TO-08/kicad-senkouka-lib/README.md

## kicad-senkouka-lib
本ライブラリは、授業で使用するKicadのライブラリになります。

## ライセンス
ライセンスはフリーとしますが、再配布は行わないようにしてください。<br>
また、個人的に使用しても良いですが、何があっても自己責任でお願いします。

## インストール方法
①GitHubにあるコードを任意の場所にダウンロードします。<br>
②ダウンロードしたフォルダにある『シンボルライブラリ』と『フットプリントライブラリ』をKicadのライブラリに登録します。<br>
③Kicadのライブラリへの登録は、『設定』の各ライブラリの管理から行います。<br>
<br>
④ライブラリの管理画面を開いたら、下の方にある『フォルダを開く』を選択して、ダウンロードしたライブラリを選択します。<br>
<br>
<br>
⑤『senkouka_lib』がライブラリに登録されていればOKです。<br>
　※『フットプリントライブラリ』も同様に登録してください。<br>
<br>
