TO-08/kicad-senkouka-lib/3D/1N5226B.stp

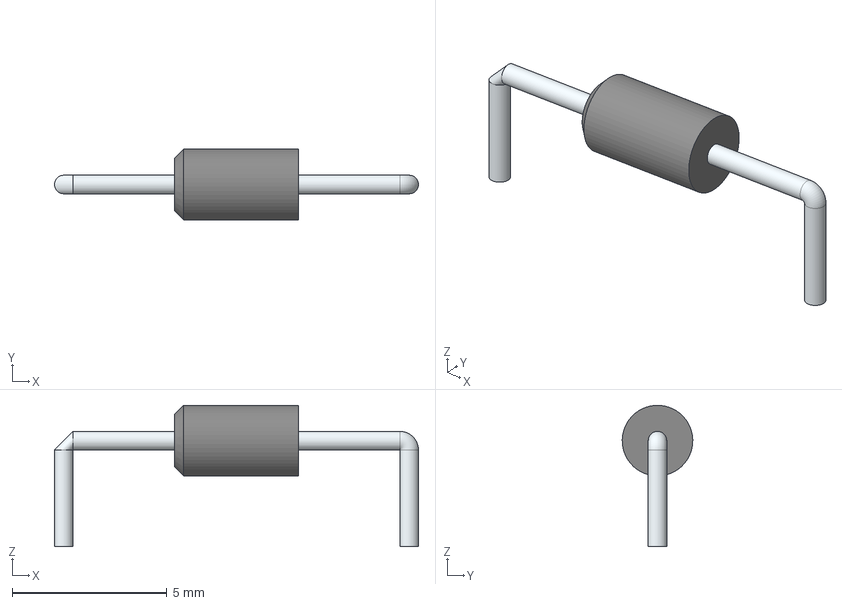
[picture p1: CAD file, 2023-06-08]
3D/1N5226B.stp
11.7 x 2.28 x 4.56 mm
