TO-08/kicad-senkouka-lib/3D/LM2940CT-12_NOPB.stp

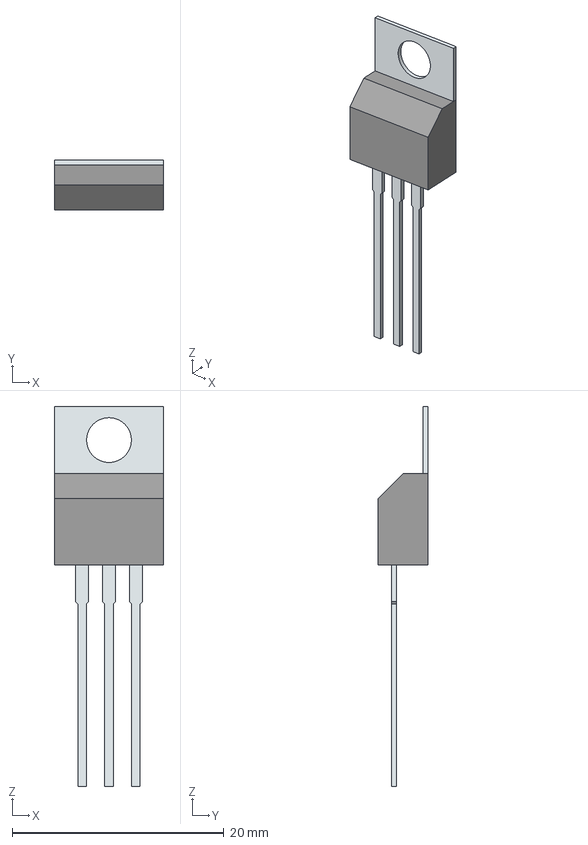
[picture p2: CAD file, 2023-06-08]
3D/LM2940CT-12_NOPB.stp
10.3 x 4.70 x 35.9 mm
Tab
PinsArray
