TO-08/kicad-senkouka-lib/3D/B5B-XH-A__LF__SN_.stp

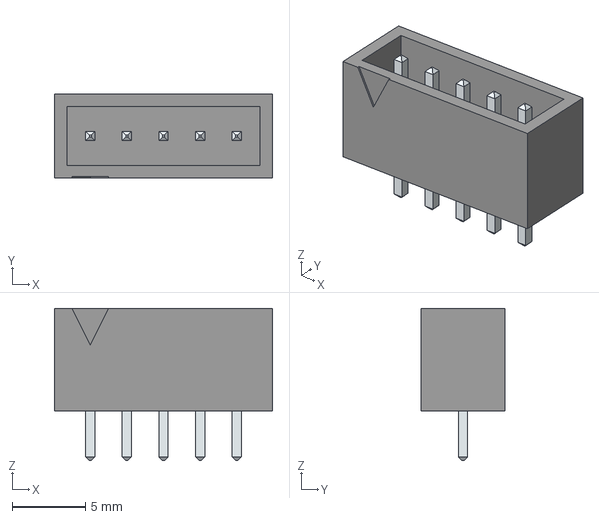
[picture p3: CAD file, 2023-06-08]
3D/B5B-XH-A__LF__SN_.stp
14.9 x 5.75 x 10.4 mm
LeadsArray
