TO-08/kicad-senkouka-lib/3D/SS2040FL.stp

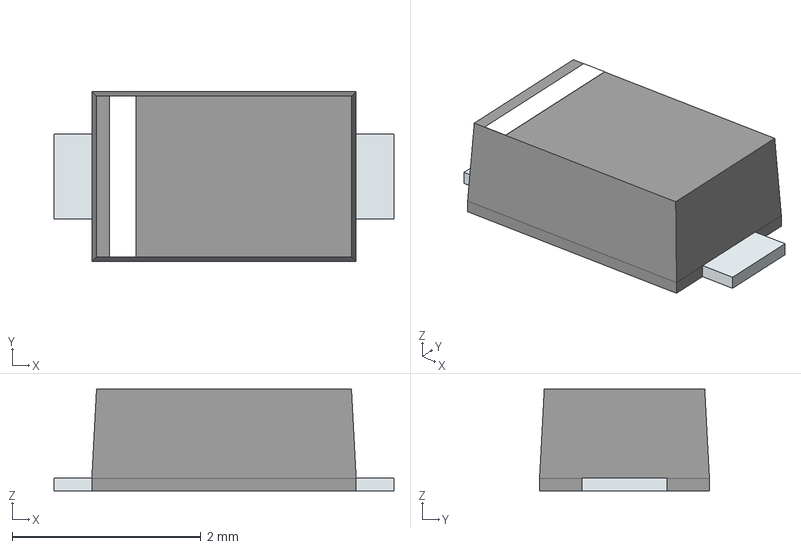
[picture p5: CAD file, 2023-06-08]
3D/SS2040FL.stp
3.60 x 1.80 x 1.08 mm
PinKIdent
PinK
PinA
