TO-08/kicad-senkouka-lib/3D/B2B-XH-A_LF__SN_.stp

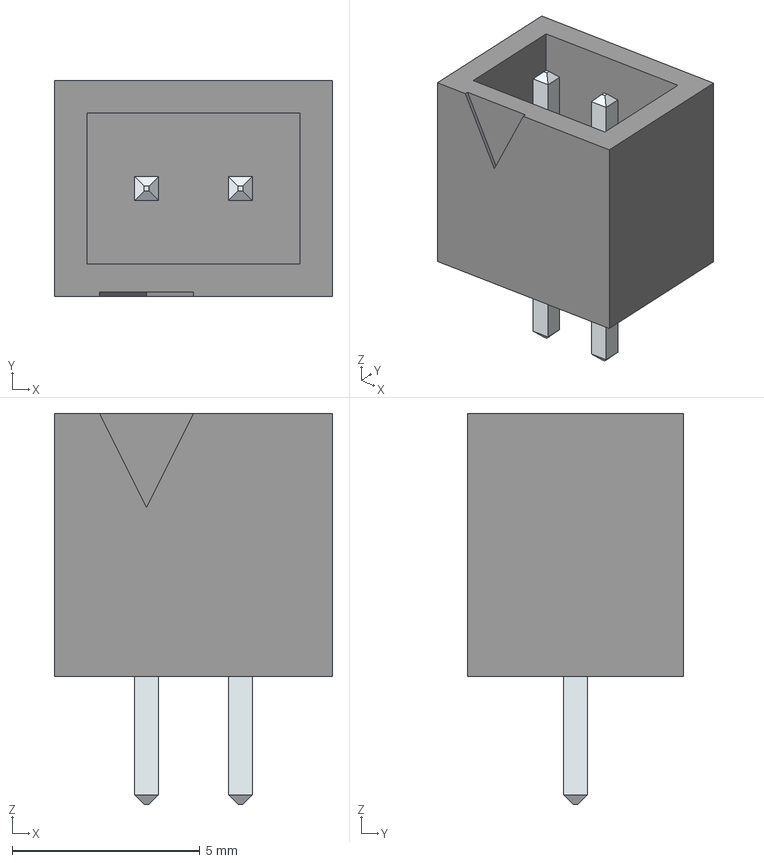
[picture p7: CAD file, 2023-06-08]
3D/B2B-XH-A_LF__SN_.stp
7.40 x 5.75 x 10.4 mm
LeadsArray
