TO-08/kicad-senkouka-lib/3D/B6B-XH-A_LF__SN_.stp

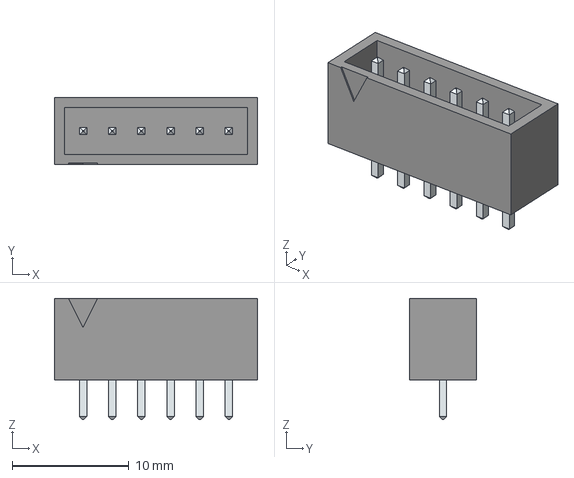
[picture p8: CAD file, 2023-06-08]
3D/B6B-XH-A_LF__SN_.stp
17.4 x 5.75 x 10.4 mm
LeadsArray
