TO-08/kicad-senkouka-lib/3D/TC33X-2-102E.stp

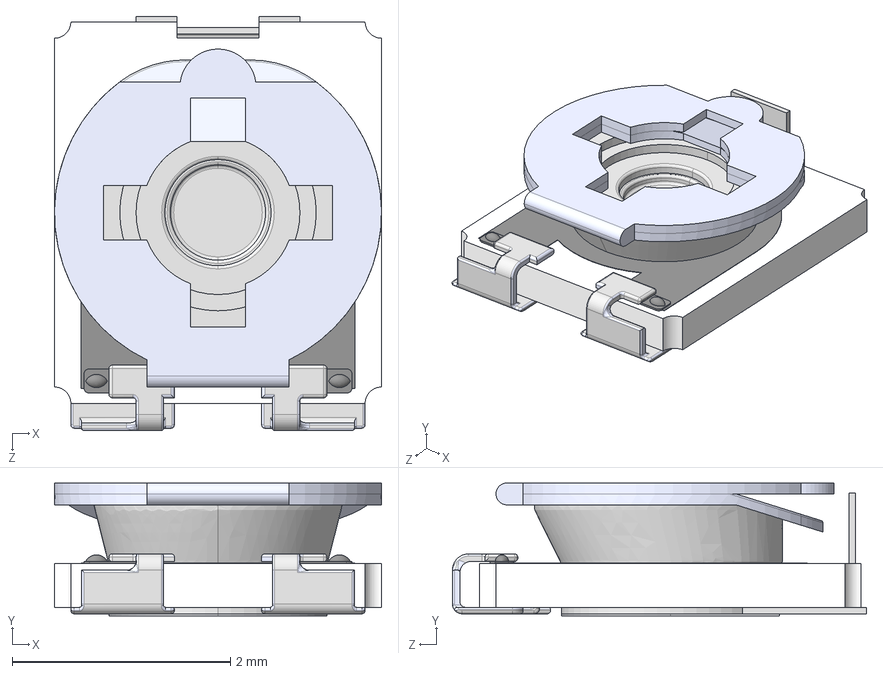
[picture p9: CAD file, 2023-06-08]
3D/TC33X-2-102E.stp
3.00 x 1.22 x 3.80 mm
