TO-08/kicad-senkouka-lib/3D/AE_TPS63802_v7_cp.step

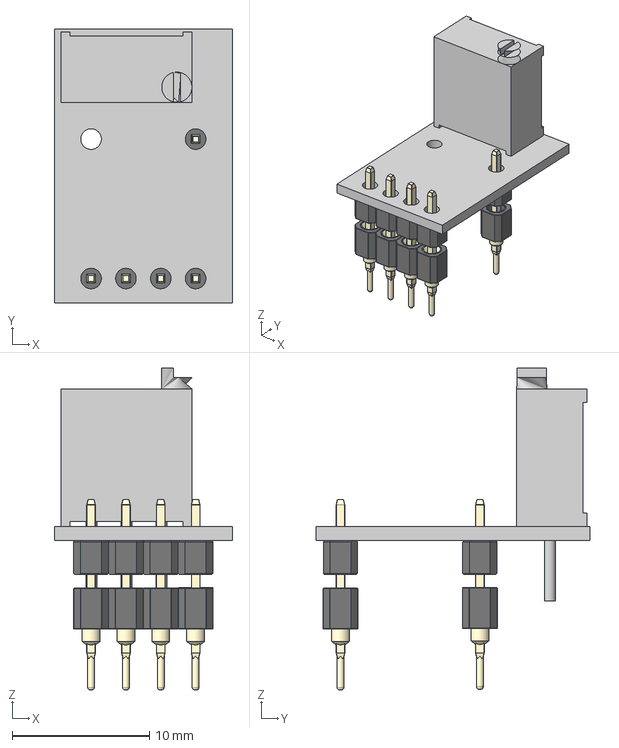
[picture p10: CAD file, 2023-06-08]
3D/AE_TPS63802_v7_cp.step
13.0 x 20.0 x 23.5 mm
