TO-08/kicad-senkouka-lib/3D/IR2302PBF.stp

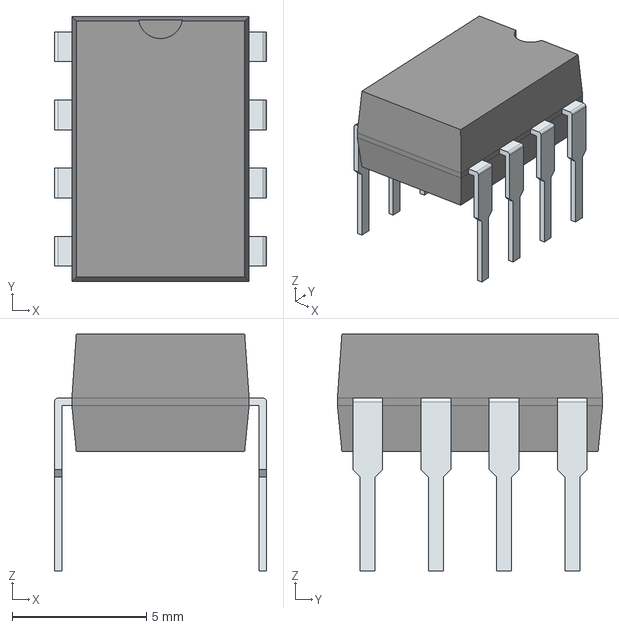
[picture p11: CAD file, 2023-06-08]
3D/IR2302PBF.stp
7.90 x 9.88 x 8.83 mm
PinsArrayLR
