TO-08/kicad-senkouka-lib/3D/LBR-127HLD.stp

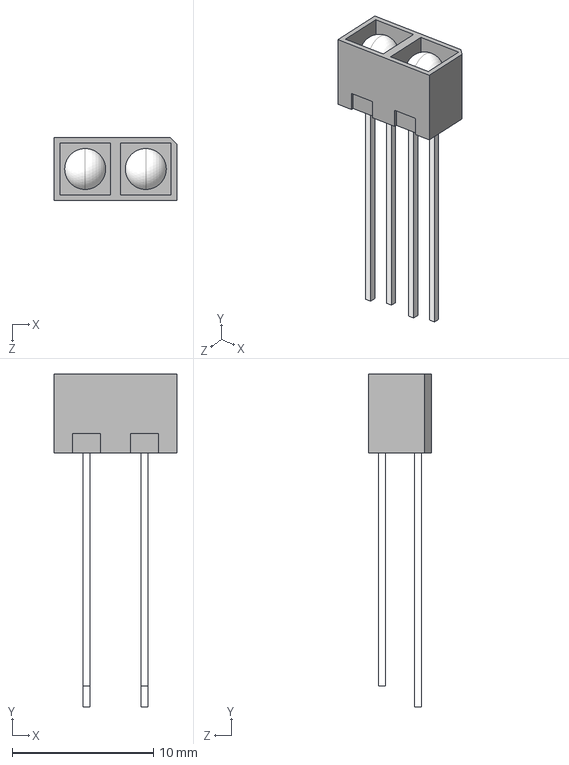
[picture p12: CAD file, 2023-06-08]
3D/LBR-127HLD.stp
8.70 x 23.6 x 4.50 mm
