TO-08/kicad-senkouka-lib/3D/TS-1187A-C-G-B.stp

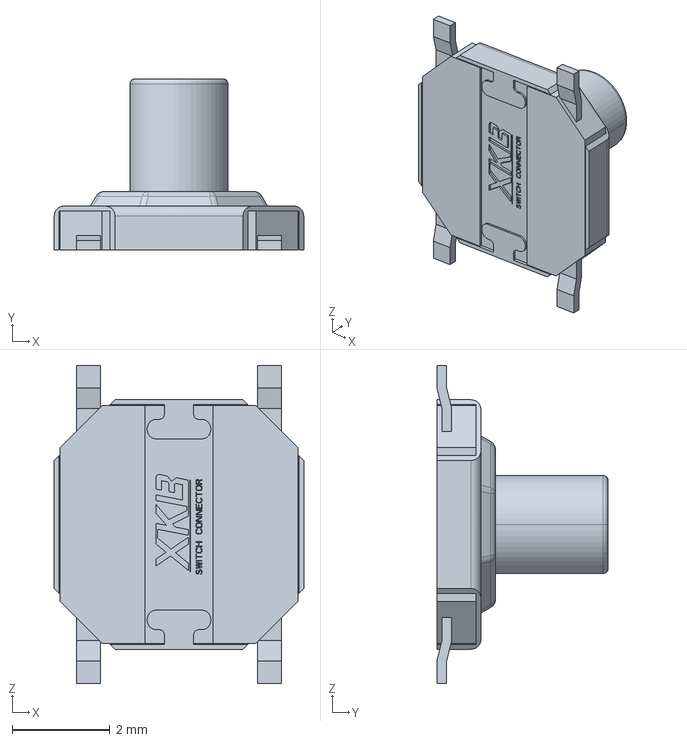
[picture p13: CAD file, 2023-06-08]
3D/TS-1187A-C-G-B.stp
5.10 x 3.50 x 6.50 mm
