TO-08/kicad-senkouka-lib/3D/TS0606FNBLK v1.step

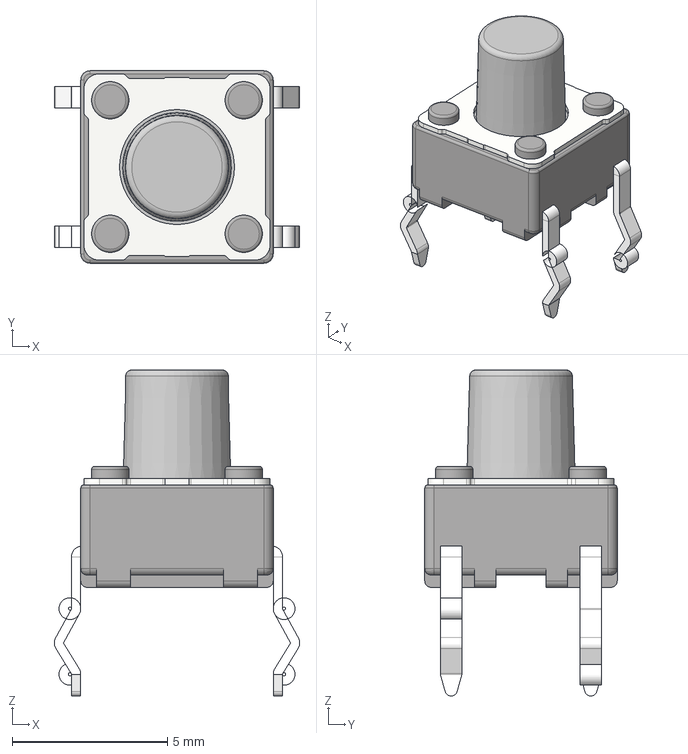
[picture p14: CAD file, 2023-06-08]
3D/TS0606FNBLK v1.step
7.90 x 6.20 x 10.5 mm
