TO-08/kicad-senkouka-lib/3D/DIP762W53P254L1969H508Q14B_v1_cp.step

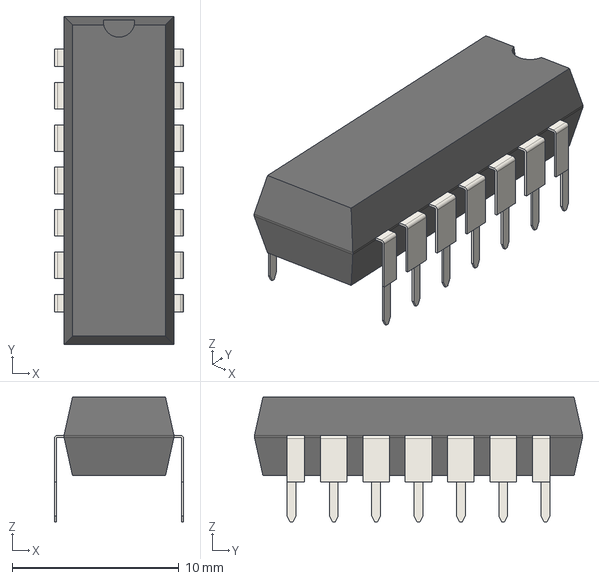
[picture p15: CAD file, 2023-06-08]
3D/DIP762W53P254L1969H508Q14B_v1_cp.step
7.74 x 19.7 x 7.48 mm
