TO-08/kicad-senkouka-lib/3D/YC164-JR-074K7L.stp

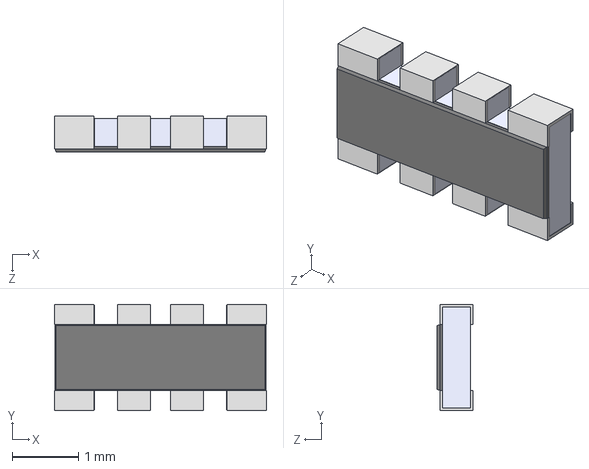
[picture p16: CAD file, 2023-06-08]
3D/YC164-JR-074K7L.stp
3.20 x 1.60 x 0.55 mm
