TO-08/kicad-senkouka-lib/3D/RX220_v11_cp.step

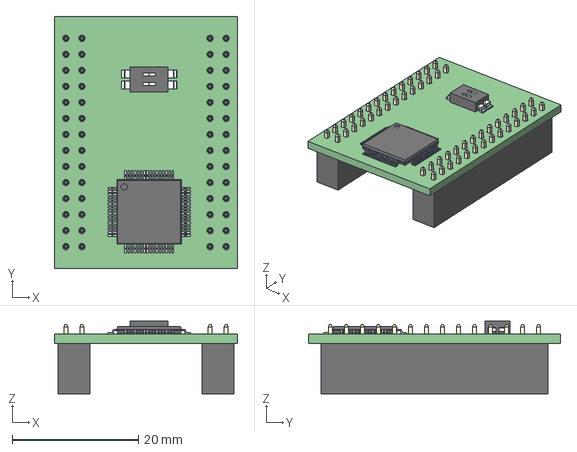
[picture p17: CAD file, 2023-06-08]
3D/RX220_v11_cp.step
29.0 x 40.0 x 11.5 mm
