TO-08/kicad-senkouka-lib/3D/AE_TC78H653FTG_v3_cp.step

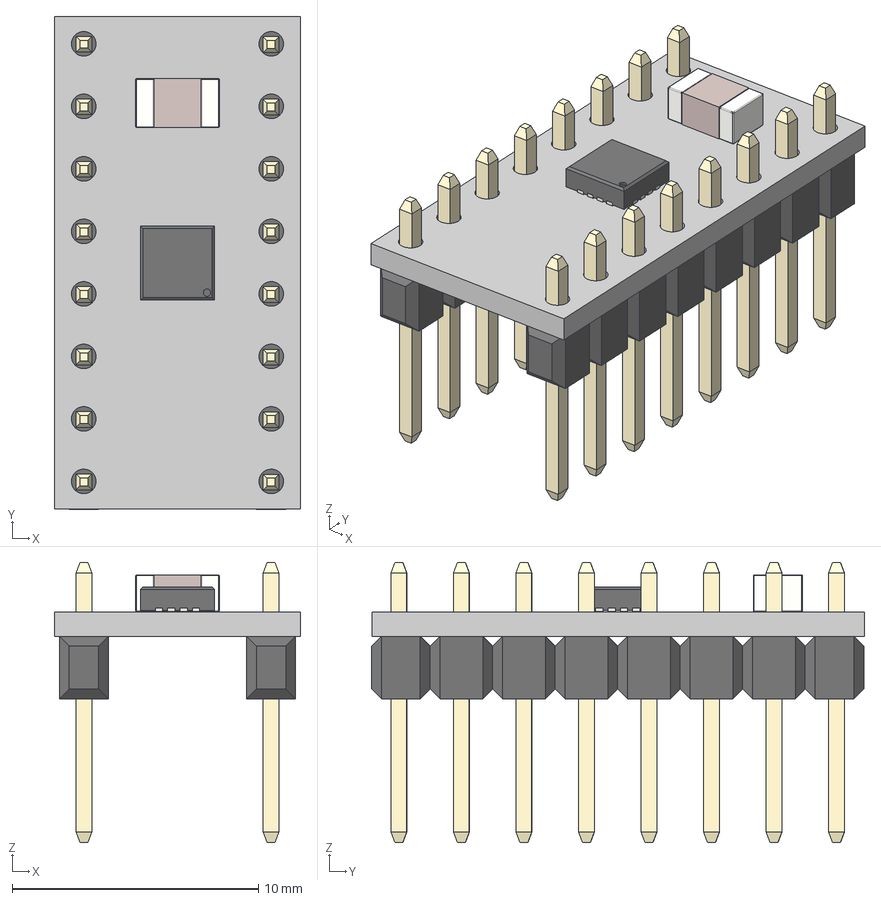
[picture p18: CAD file, 2023-06-08]
3D/AE_TC78H653FTG_v3_cp.step
10.0 x 20.0 x 11.4 mm
