TO-08/kicad-senkouka-lib/3D/3362P-1-501.stp

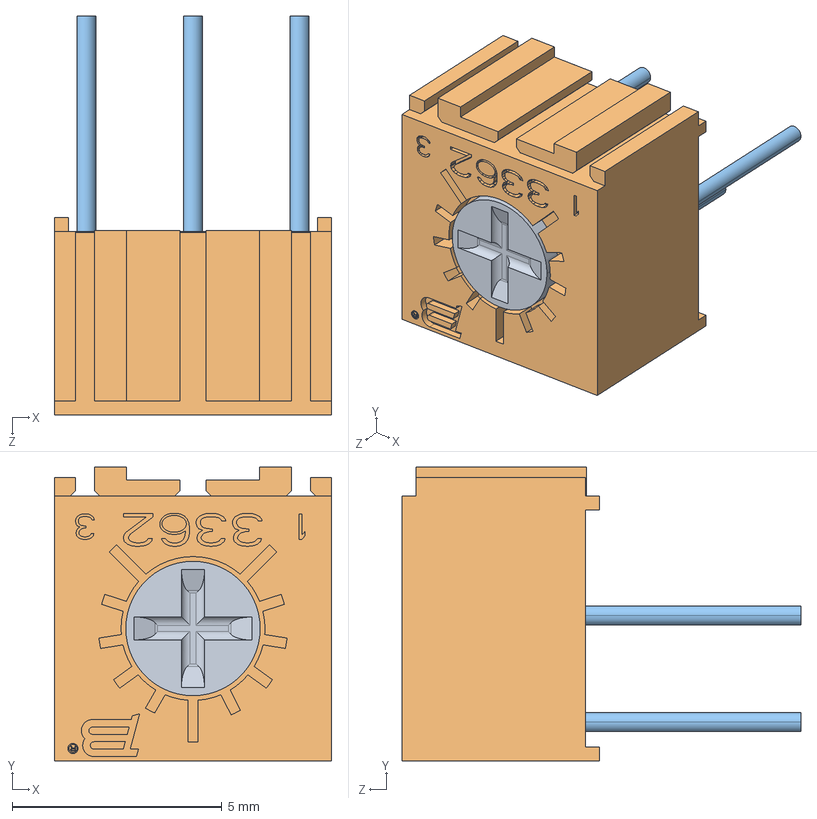
[picture p19: CAD file, 2023-06-08]
3D/3362P-1-501.stp
6.60 x 6.99 x 9.50 mm
