TO-08/kicad-senkouka-lib/3D/RPR-220PC30N.stp

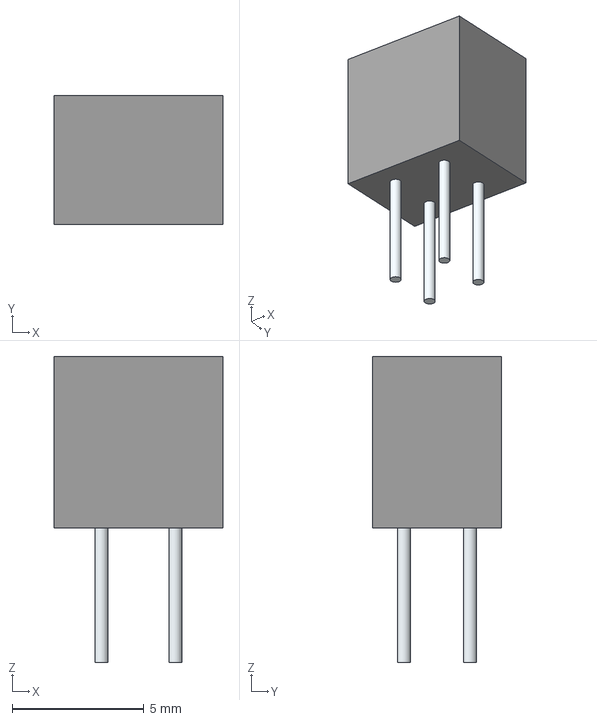
[picture p20: CAD file, 2023-06-08]
3D/RPR-220PC30N.stp
6.40 x 4.90 x 11.6 mm
Leads x 4
