TO-08/kicad-senkouka-lib/3D/74HC04D,653.stp

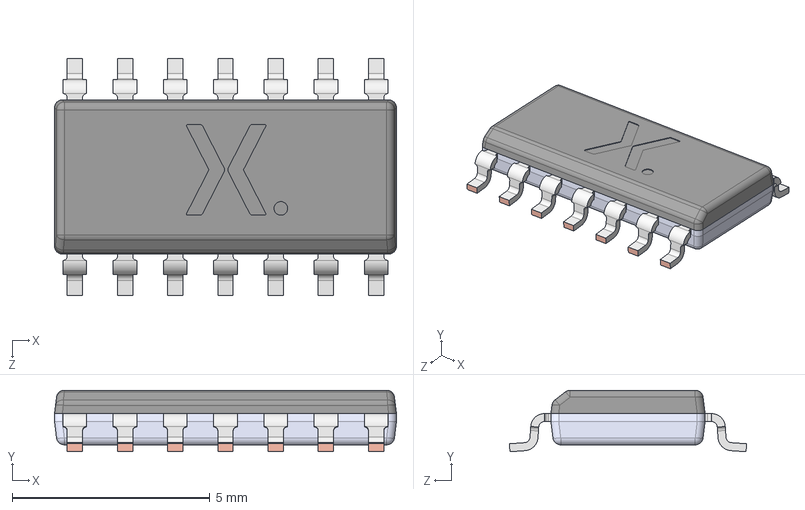
[picture p21: CAD file, 2023-06-08]
3D/74HC04D,653.stp
8.65 x 1.56 x 6.00 mm
SOT108 lower body
SOT108 upper body
SOT108-1 Lead
