TO-08/kicad-senkouka-lib/3D/TK40E06N1,S1X_S.stp

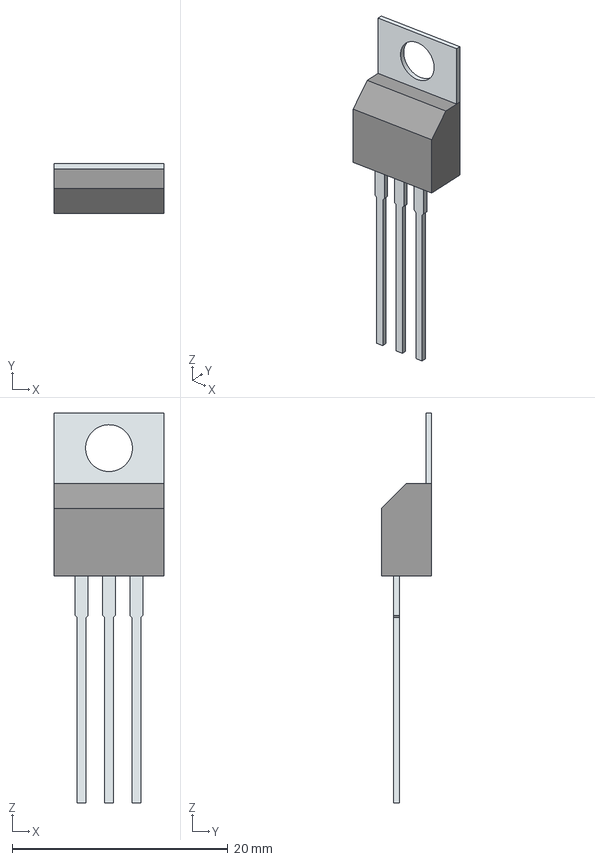
[picture p22: CAD file, 2023-06-08]
3D/TK40E06N1,S1X_S.stp
10.2 x 4.65 x 36.1 mm
Tab
PinsArray
