TO-08/kicad-senkouka-lib/3D/SS-12D01G3 v1.step

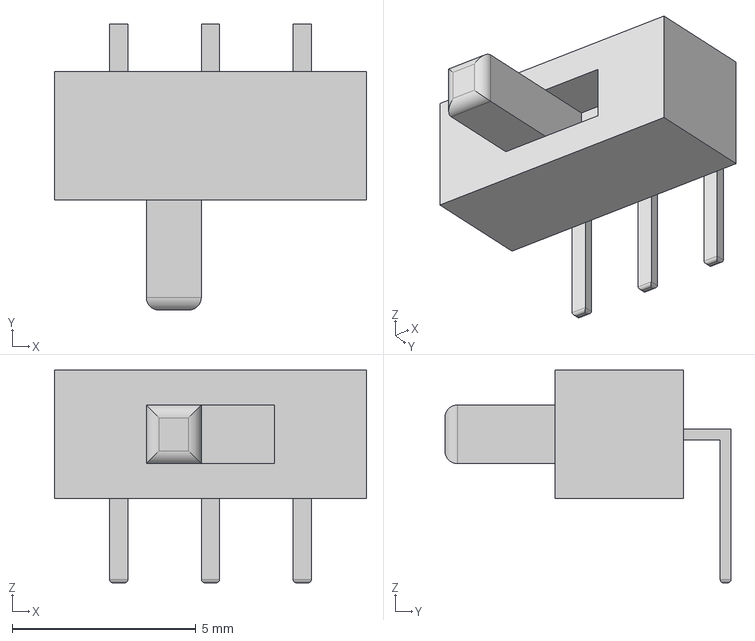
[picture p23: CAD file, 2023-06-08]
3D/SS-12D01G3 v1.step
8.50 x 7.80 x 5.80 mm
