TO-08/kicad-senkouka-lib/3D/TerminalBlock_v1_cp.step

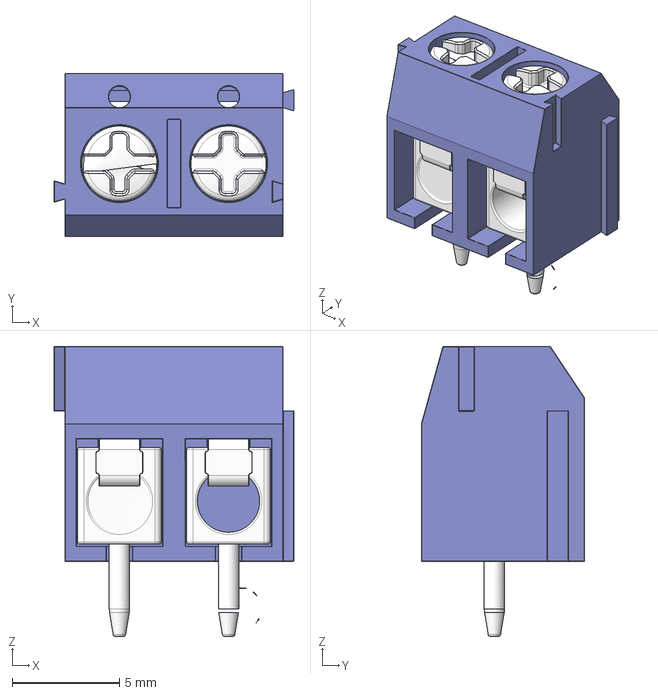
[picture p24: CAD file, 2023-06-08]
3D/TerminalBlock_v1_cp.step
11.2 x 7.60 x 13.5 mm
