TO-08/kicad-senkouka-lib/(commit log)

2023-06-07 ブランチ作成
2023-06-08 ローカルのファイルを登録
    [3362P-1-501.stp, 74HC04D,653.stp, 74LVC1G17GW,125.stp, AE_TC78H653FTG_v3_cp.step, AE_TPS63802_v7_cp.step, DIP762W53P254L1969H508Q14B_v1_cp.step, IR2302PBF.stp, LBR-127HLD.stp]
2023-06-08 3Dモデルのパスを相対パスに修正
    [1N5226B.stp, B2B-XH-A_LF__SN_.stp, B3B-XH-A_LF__SN_.stp, B4B-XH-A_LF__SN_.stp, B5B-XH-A__LF__SN_.stp, B6B-XH-A_LF__SN_.stp, LHL08NB470K.stp, LM2940CT-12_NOPB.stp]
2023-06-08 readme修正
